ctogit/poncho-ciaa-rema/README.md

# poncho-ciaa-rema
Desarrollo de placa poncho para placa CIAA-NXP en el marco del proyecto de reacondicionamiento electrónico del telemanipulador cartesiano "REMA".
