ctogit/poncho-ciaa-rema/Fabricación_pcb_PonchoPicoCIAA.docx

PLACA PONCHO RPi-PICO/CIAA – PROYECTO REMA

Dimensiones: 138.6 mm x 86.19 mm

Capas: doble faz

1. Serigrafía capa superior
2. Máscara anti-soldante capa superior
3. Cobre capa superior
4. Cobre capa inferior
5. Máscara anti-soldante capa inferior
6. Serigrafía capa inferior

Agujeros metalizados: si

Material: FR4

Espesor: 1.6mm

Cantidad: 5

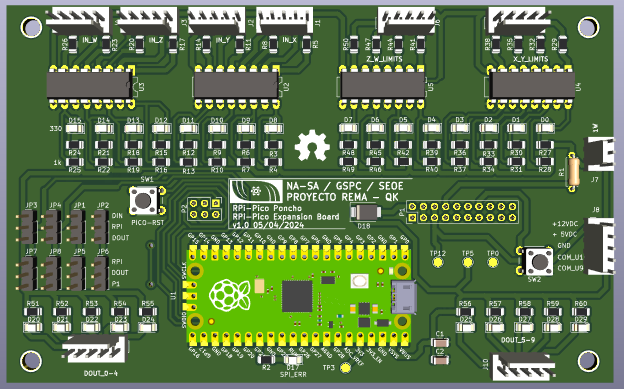
[picture p1: figure]
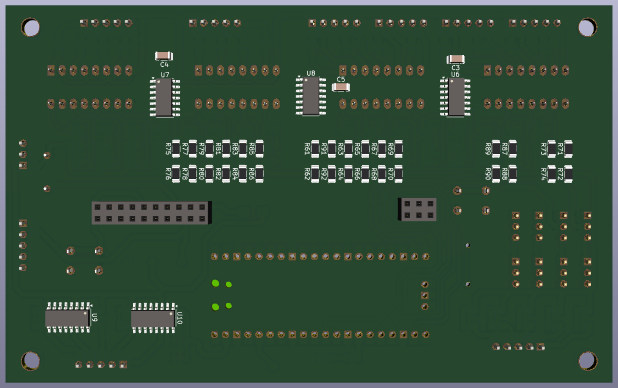
[picture p2: figure]
