ctogit/poncho-ciaa-rema/(list of files, drawings)

Other design files:
Simulaciones/PonchoTest.pdsprj
