ctogit/poncho-ciaa-rema/PonchoRema.kicad_pcb

## KiCad design PonchoRema.kicad_pcb (2024-04-05)

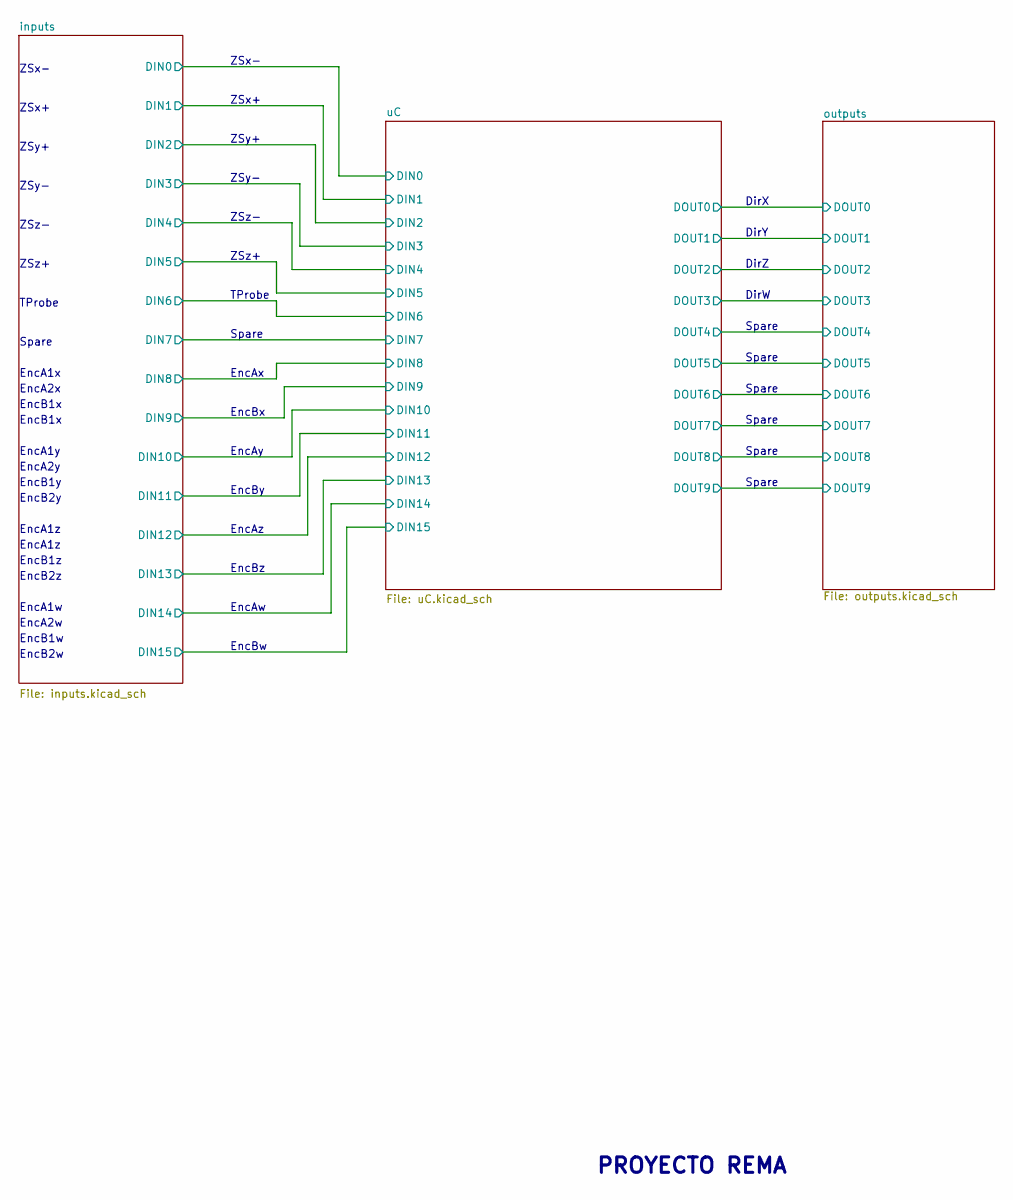
[picture p11: schematic PonchoRema.kicad_sch, Poncho-CIAA]

Notes on the sheet:
ZSx+
ZSz+
EncB1y
Spare
EncAy
EncAw
EncBz
ZSx-
EncB2y
EncA2y
TProbe
ZSy+
EncA1w
EncBx
EncB2z
ZSy-
EncB1x
EncB2w
EncB1z
EncA1z
EncBw
ZSz-
EncA2w
DirW
EncBy
EncAz
EncA1y
EncA2x
DirZ
DirY
EncAx
EncB1w
PROYECTO REMA
EncA1x
DirX

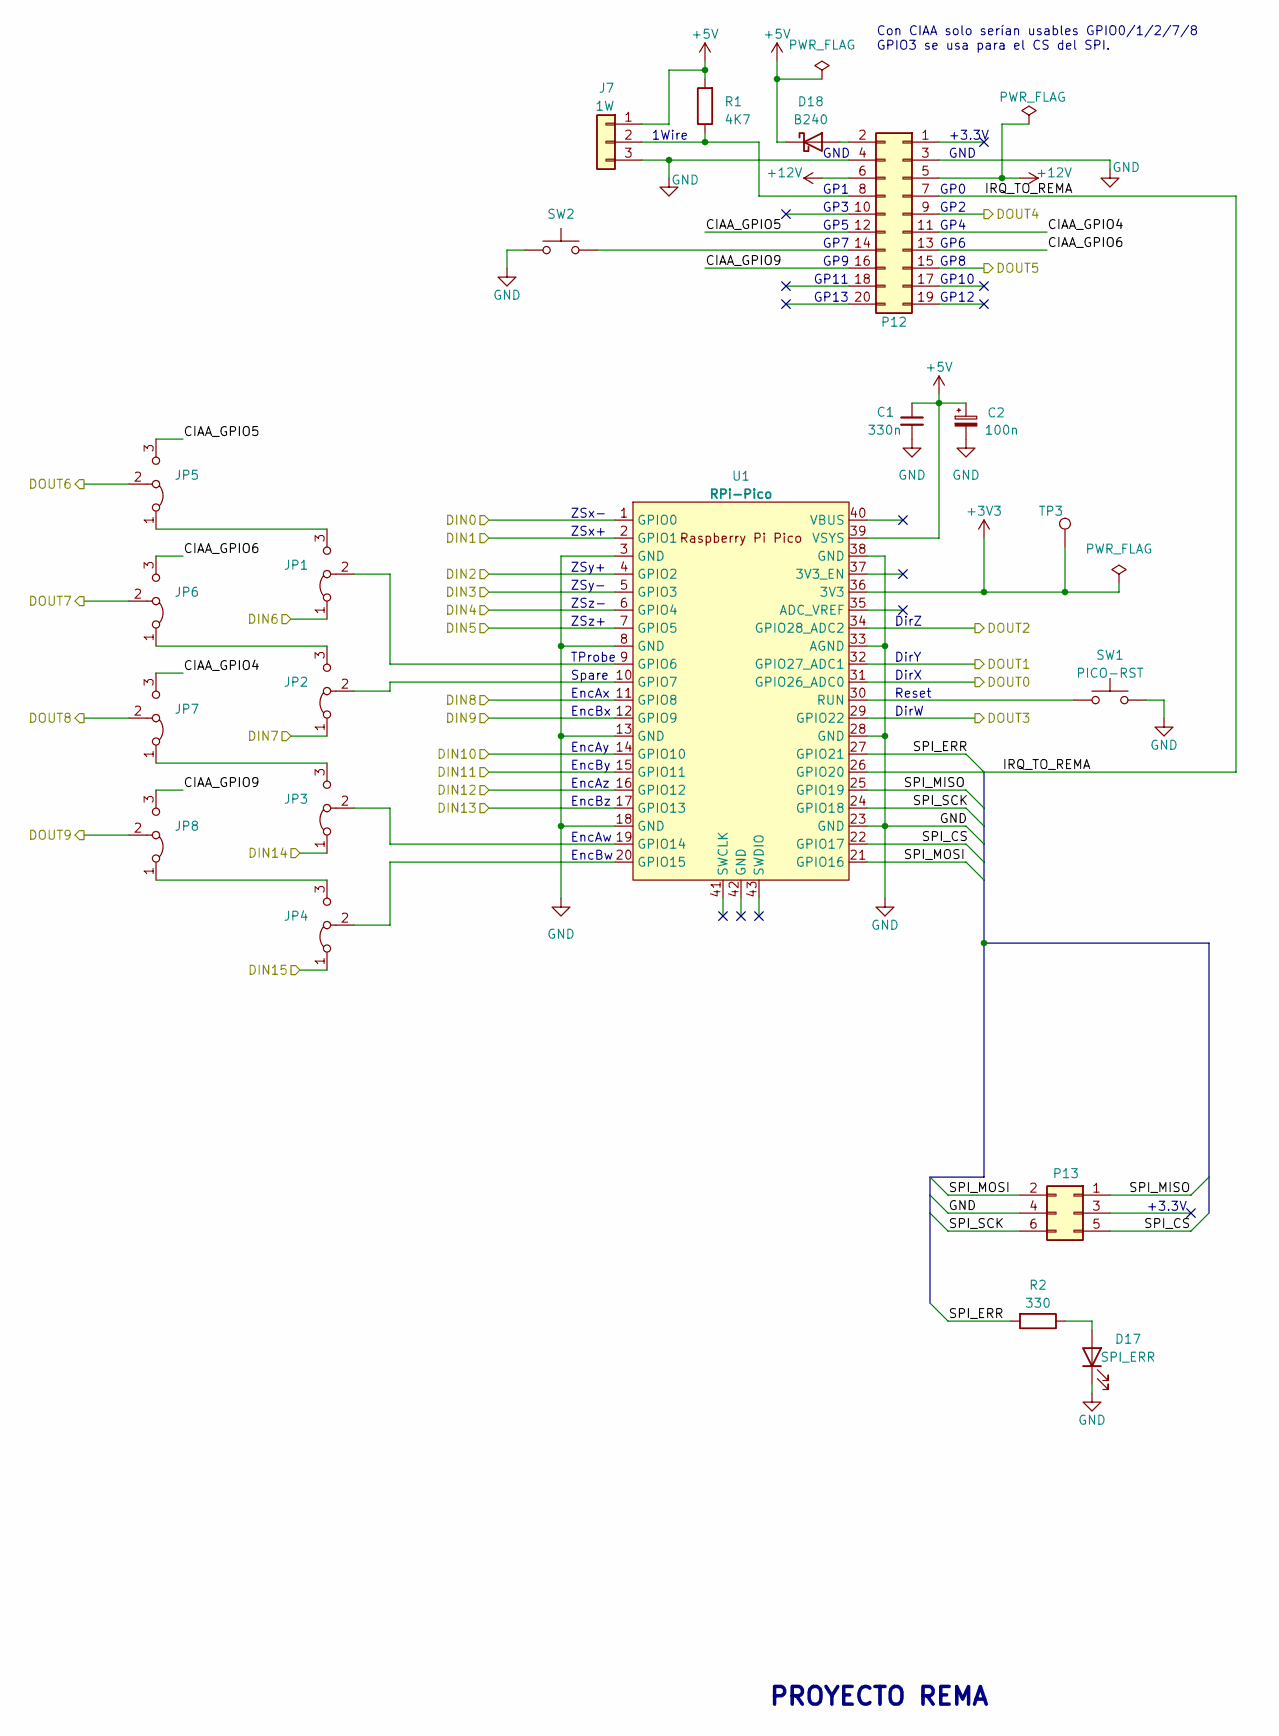
[picture p12: schematic uC.kicad_sch, Microcontrolador y fuentes]

Parts:
C1: 330n; C_1206_3216Metric
C2: 100n; C_1206_3216Metric
D17: SPI_ERR; LED_1206_3216Metric
D18: B240; D_SMB
J7: 1W; PinHeader_1x03_P2.54mm_Vertical
JP1, JP2, JP3, JP4, JP5, JP6, JP7, JP8: Jumper_3_Bridged12; PinHeader_1x03_P2.54mm_Vertical
P12: Conn_02x10_Odd_Even; PinHeader_2x10_P2.54mm_Vertical
P13: PinHeader_2x03_P2.54mm_Vertical
R1: 4K7; R_Axial_DIN0207_L6.3mm_D2.5mm_P7.62mm_Horizontal
R2: 330; R_1206_3216Metric
SW1: PICO-RST; SW_PUSH_6mm
SW2: SW_Push; SW_PUSH_6mm
TP3: TestPoint; TestPoint_Pad_D2.0mm
U1: RPi-Pico; RPi_Pico_SMD_TH

Connections:
+3V3: TP3.1, U1.36 (3V3)
+5V: C1.1, C2.1, D18.1 (K), J7.1, R1.2, U1.39 (VSYS); also elsewhere on the board
/inputs/DIN0: U1.1 (GPIO0); also elsewhere on the board
/inputs/DIN1: U1.2 (GPIO1); also elsewhere on the board
/inputs/DIN2: U1.4 (GPIO2); also elsewhere on the board
/inputs/DIN3: U1.5 (GPIO3); also elsewhere on the board
/inputs/DIN4: U1.6 (GPIO4); also elsewhere on the board
/inputs/DIN5: U1.7 (GPIO5); also elsewhere on the board
/inputs/DIN6: JP1.1 (A); also elsewhere on the board
/inputs/DIN7: JP2.1 (A); also elsewhere on the board
/inputs/DIN8: U1.11 (GPIO8); also elsewhere on the board
/inputs/DIN9: U1.12 (GPIO9); also elsewhere on the board
/inputs/DIN10: U1.14 (GPIO10); also elsewhere on the board
/inputs/DIN11: U1.15 (GPIO11); also elsewhere on the board
/inputs/DIN12: U1.16 (GPIO12); also elsewhere on the board
/inputs/DIN13: U1.17 (GPIO13); also elsewhere on the board
/inputs/DIN14: JP3.1 (A); also elsewhere on the board
/inputs/DIN15: JP4.1 (A); also elsewhere on the board
/outputs/DOUT0: U1.31 (GPIO26_ADC0); also elsewhere on the board
/outputs/DOUT1: U1.32 (GPIO27_ADC1); also elsewhere on the board
/outputs/DOUT2: U1.34 (GPIO28_ADC2); also elsewhere on the board
/outputs/DOUT3: U1.29 (GPIO22); also elsewhere on the board
/outputs/DOUT6: JP5.2 (C); also elsewhere on the board
/outputs/DOUT7: JP6.2 (C); also elsewhere on the board
/outputs/DOUT8: JP7.2 (C); also elsewhere on the board
/outputs/DOUT9: JP8.2 (C); also elsewhere on the board
/uC/CIAA_GPIO4: JP7.3 (B); also elsewhere on the board
/uC/CIAA_GPIO5: JP5.3 (B); also elsewhere on the board
/uC/CIAA_GPIO6: JP6.3 (B); also elsewhere on the board
/uC/CIAA_GPIO9: JP8.3 (B); also elsewhere on the board
/uC/IRQ_TO_REMA: U1.26 (GPIO20); also elsewhere on the board
/uC/SPI_CS: U1.22 (GPIO17); also elsewhere on the board
/uC/SPI_ERR: R2.2, U1.27 (GPIO21)
/uC/SPI_MISO: U1.25 (GPIO19); also elsewhere on the board
/uC/SPI_MOSI: U1.21 (GPIO16); also elsewhere on the board
/uC/SPI_SCK: U1.24 (GPIO18); also elsewhere on the board
GND: C1.2, C2.2, D17.1 (K), J7.3, SW1.2, SW2.1, U1.3 (GND), U1.8 (GND), U1.13 (GND), U1.18 (GND), U1.23 (GND), U1.28 (GND), U1.33 (AGND), U1.38 (GND); also elsewhere on the board
unnamed: D17.2 (A), R2.1
unnamed 84: D18.2 (A); also elsewhere on the board
unnamed 119: J7.2, R1.1; also elsewhere on the board
unnamed: JP1.3 (B), JP5.1 (A)
unnamed: JP1.2 (C), U1.9 (GPIO6)
unnamed: JP2.3 (B), JP6.1 (A)
unnamed: JP2.2 (C), U1.10 (GPIO7)
unnamed: JP3.3 (B), JP7.1 (A)
unnamed: JP3.2 (C), U1.19 (GPIO14)
unnamed: JP4.3 (B), JP8.1 (A)
unnamed: JP4.2 (C), U1.20 (GPIO15)
unnamed 130: SW2.2; also elsewhere on the board
unnamed: SW1.1, U1.30 (RUN)

Notes on the sheet:
GND
GP12
DirW
1Wire
ZSx-
GP1
ZSy-
ZSz-
GP6
EncAz
Con CIAA solo serían usables GPIO0/1/2/7/8 GPIO3 se usa para el CS del SPI.
Reset
GP13
GP8
EncBy
EncBz
ZSz+
DirX
GP2
EncBx
GP7
GP11
Spare
TProbe
GP9
EncAx
DirY
ZSx+
GP5
+3.3V
EncAy
GP3
ZSy+
GP10
EncAw
GP4
EncBw
GP0
PROYECTO REMA
DirZ

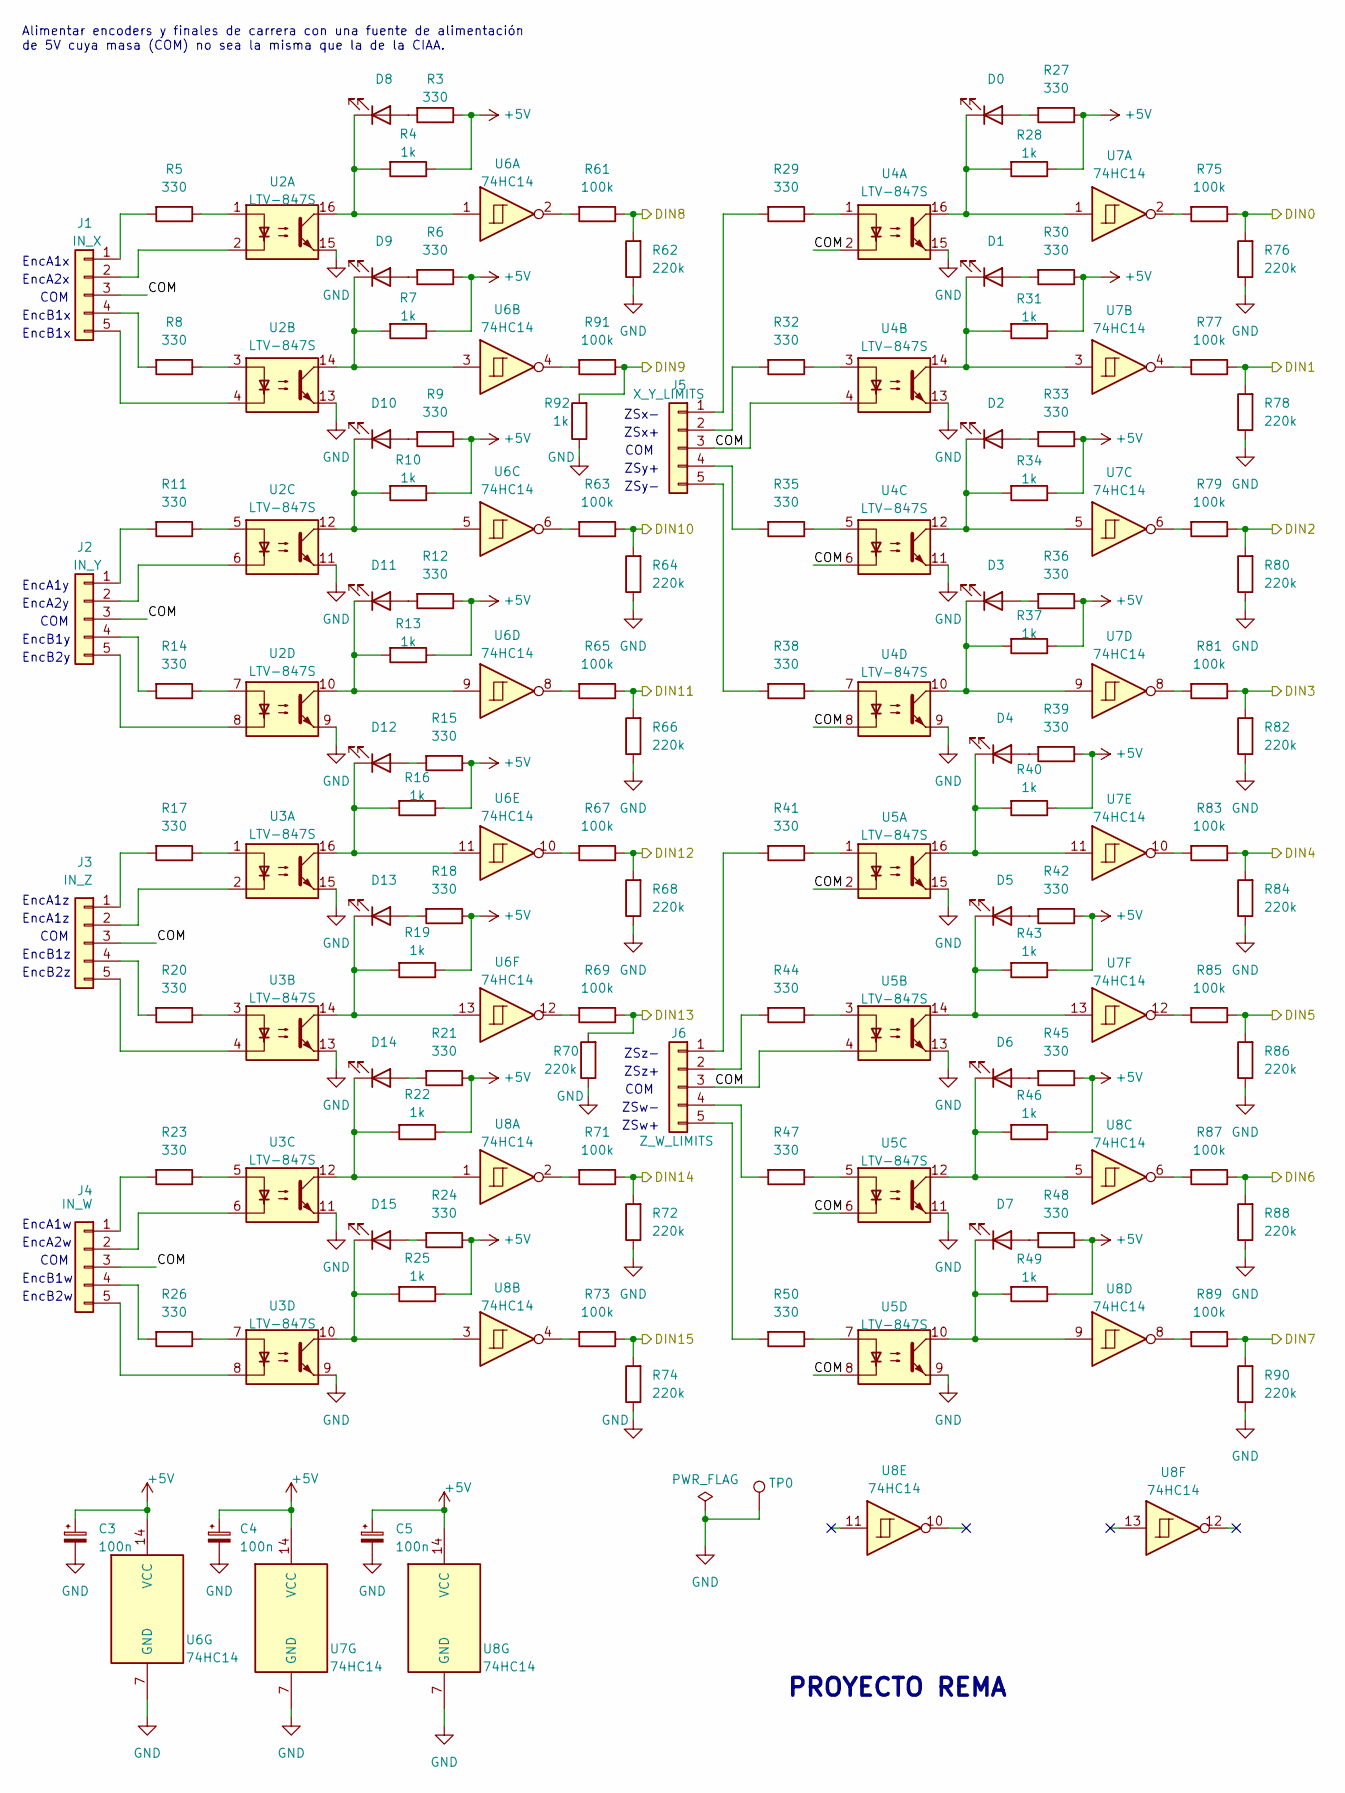
[picture p13: schematic inputs.kicad_sch, Entradas]

Parts:
C3, C4, C5: 100n; C_1206_3216Metric
D0, D1, D2, D3, D4, D5, D6, D7, D8, D9, D10, D11, D12, D13, D14, D15: LedGreen; LED_1206_3216Metric
J1: IN_X; PinHeader_1x05_P2.54mm_Vertical
J2: IN_Y; PinHeader_1x05_P2.54mm_Vertical
J3: IN_Z; PinHeader_1x05_P2.54mm_Vertical
J4: IN_W; PinHeader_1x05_P2.54mm_Vertical
J5: X_Y_LIMITS; PinHeader_1x05_P2.54mm_Vertical
J6: Z_W_LIMITS; PinHeader_1x05_P2.54mm_Vertical
R3, R5, R6, R8, R9, R11, R12, R14, R15, R17, R18, R20, R21, R23, R24, R26, R27, R29, R30, R32, R33, R35, R36, R38, R39, R41, R42, R44, R45, R47, R48, R50: 330; R_1206_3216Metric
R4, R7, R10, R13, R16, R19, R22, R25, R28, R31, R34, R37, R40, R43, R46, R49, R92: 1k; R_1206_3216Metric
R61, R63, R65, R67, R69, R71, R73, R75, R77, R79, R81, R83, R85, R87, R89, R91: 100k; R_1206_3216Metric
R62, R64, R66, R68, R70, R72, R74, R76, R78, R80, R82, R84, R86, R88, R90: 220k; R_1206_3216Metric
TP0: TestPoint; TestPoint_Pad_D2.0mm
U2, U3, U4, U5: LTV-847S; DIP-16_W7.62mm_LongPads
U6, U7, U8: 74HC14; SOIC-14_3.9x8.7mm_P1.27mm

Connections:
+5V: C3.1, C4.1, C5.1, R3.1, R4.1, R6.1, R7.1, R9.1, R10.1, R12.1, R13.1, R15.1, R16.1, R18.1, R19.1, R21.1, R22.1, R24.1, R25.1, R27.1, R28.1, R30.1, R31.1, R33.1, R34.1, R36.1, R37.1, R39.1, R40.1, R42.1, R43.1, R45.1, R46.1, R48.1, R49.1, U6.14 (VCC), U7.14 (VCC), U8.14 (VCC); also elsewhere on the board
/inputs/COM: J1.3, J2.3, J3.3, J4.3, J5.3, J6.3, U4.2, U4.4, U4.6, U4.8, U5.2, U5.4, U5.6, U5.8
/inputs/DIN0: R75.1, R76.2; also elsewhere on the board
/inputs/DIN1: R77.1, R78.2; also elsewhere on the board
/inputs/DIN2: R79.1, R80.2; also elsewhere on the board
/inputs/DIN3: R81.1, R82.2; also elsewhere on the board
/inputs/DIN4: R83.1, R84.2; also elsewhere on the board
/inputs/DIN5: R85.1, R86.2; also elsewhere on the board
/inputs/DIN6: R87.1, R88.2; also elsewhere on the board
/inputs/DIN7: R89.1, R90.2; also elsewhere on the board
/inputs/DIN8: R61.1, R62.2; also elsewhere on the board
/inputs/DIN9: R91.1, R92.2; also elsewhere on the board
/inputs/DIN10: R63.1, R64.2; also elsewhere on the board
/inputs/DIN11: R65.1, R66.2; also elsewhere on the board
/inputs/DIN12: R67.1, R68.2; also elsewhere on the board
/inputs/DIN13: R69.1, R70.2; also elsewhere on the board
/inputs/DIN14: R71.1, R72.2; also elsewhere on the board
/inputs/DIN15: R73.1, R74.2; also elsewhere on the board
GND: C3.2, C4.2, C5.2, R62.1, R64.1, R66.1, R68.1, R70.1, R72.1, R74.1, R76.1, R78.1, R80.1, R82.1, R84.1, R86.1, R88.1, R90.1, R92.1, TP0.1, U2.9, U2.11, U2.13, U2.15, U3.9, U3.11, U3.13, U3.15, U4.9, U4.11, U4.13, U4.15, U5.9, U5.11, U5.13, U5.15, U6.7 (GND), U7.7 (GND), U8.7 (GND); also elsewhere on the board
unnamed: D0.2 (A), R27.2
unnamed: D0.1 (K), R28.2, U4.16, U7.1
unnamed: D1.2 (A), R30.2
unnamed: D1.1 (K), R31.2, U4.14, U7.3
unnamed: D2.2 (A), R33.2
unnamed: D2.1 (K), R34.2, U4.12, U7.5
unnamed: D3.2 (A), R36.2
unnamed: D3.1 (K), R37.2, U4.10, U7.9
unnamed: D4.2 (A), R39.2
unnamed: D4.1 (K), R40.2, U5.16, U7.11
unnamed: D5.2 (A), R42.2
unnamed: D5.1 (K), R43.2, U5.14, U7.13
unnamed: D6.2 (A), R45.2
unnamed: D6.1 (K), R46.2, U5.12, U8.5
unnamed: D7.2 (A), R48.2
unnamed: D7.1 (K), R49.2, U5.10, U8.9
unnamed: D8.2 (A), R3.2
unnamed: D8.1 (K), R4.2, U2.16, U6.1
unnamed: D9.2 (A), R6.2
unnamed: D9.1 (K), R7.2, U2.14, U6.3
unnamed: D10.2 (A), R9.2
unnamed: D10.1 (K), R10.2, U2.12, U6.5
unnamed: D11.2 (A), R12.2
unnamed: D11.1 (K), R13.2, U2.10, U6.9
unnamed: D12.2 (A), R15.2
unnamed: D12.1 (K), R16.2, U3.16, U6.11
unnamed: D13.2 (A), R18.2
unnamed: D13.1 (K), R19.2, U3.14, U6.13
unnamed: D14.2 (A), R21.2
unnamed: D14.1 (K), R22.2, U3.12, U8.1
unnamed: D15.2 (A), R24.2
unnamed: D15.1 (K), R25.2, U3.10, U8.3
unnamed: J1.1, R5.2
unnamed: J1.2, U2.2
unnamed: J1.4, R8.2
unnamed: J1.5, U2.4
unnamed: J2.1, R11.2
unnamed: J2.2, U2.6
unnamed: J2.4, R14.2
unnamed: J2.5, U2.8
unnamed: J3.1, R17.2
unnamed: J3.2, U3.2
unnamed: J3.4, R20.2
unnamed: J3.5, U3.4
unnamed: J4.1, R23.2
unnamed: J4.2, U3.6
unnamed: J4.4, R26.2
unnamed: J4.5, U3.8
unnamed: J5.1, R29.2
unnamed: J5.2, R32.2
unnamed: J5.4, R35.2
unnamed: J5.5, R38.2
unnamed: J6.1, R41.2
unnamed: J6.2, R44.2
unnamed: J6.4, R47.2
unnamed: J6.5, R50.2
unnamed: R5.1, U2.1
unnamed: R8.1, U2.3
unnamed: R11.1, U2.5
unnamed: R14.1, U2.7
unnamed: R17.1, U3.1
unnamed: R20.1, U3.3
unnamed: R23.1, U3.5
unnamed: R26.1, U3.7
unnamed: R29.1, U4.1
unnamed: R32.1, U4.3
unnamed: R35.1, U4.5
unnamed: R38.1, U4.7
unnamed: R41.1, U5.1
unnamed: R44.1, U5.3
unnamed: R47.1, U5.5
unnamed: R50.1, U5.7
unnamed: R61.2, U6.2
unnamed: R63.2, U6.6
unnamed: R65.2, U6.8
unnamed: R67.2, U6.10
unnamed: R69.2, U6.12
unnamed: R71.2, U8.2
unnamed: R73.2, U8.4
unnamed: R75.2, U7.2
unnamed: R77.2, U7.4
unnamed: R79.2, U7.6
unnamed: R81.2, U7.8
unnamed: R83.2, U7.10
unnamed: R85.2, U7.12
unnamed: R87.2, U8.6
unnamed: R89.2, U8.8
unnamed: R91.2, U6.4

Notes on the sheet:
ZSy+
EncA2w
ZSz-
EncA1z
ZSx+
COM
EncB1w
EncA1w
EncB1y
EncA1x
EncB2y
EncA2y
PROYECTO REMA
EncB1z
ZSw-
Alimentar encoders y finales de carrera con una fuente de alimentación de 5V cuya masa (COM) no sea la misma que la de la CIAA.
EncB1x
EncA1y
EncB2z
ZSx-
ZSz+
ZSw+
ZSy-
EncA2x
EncB2w

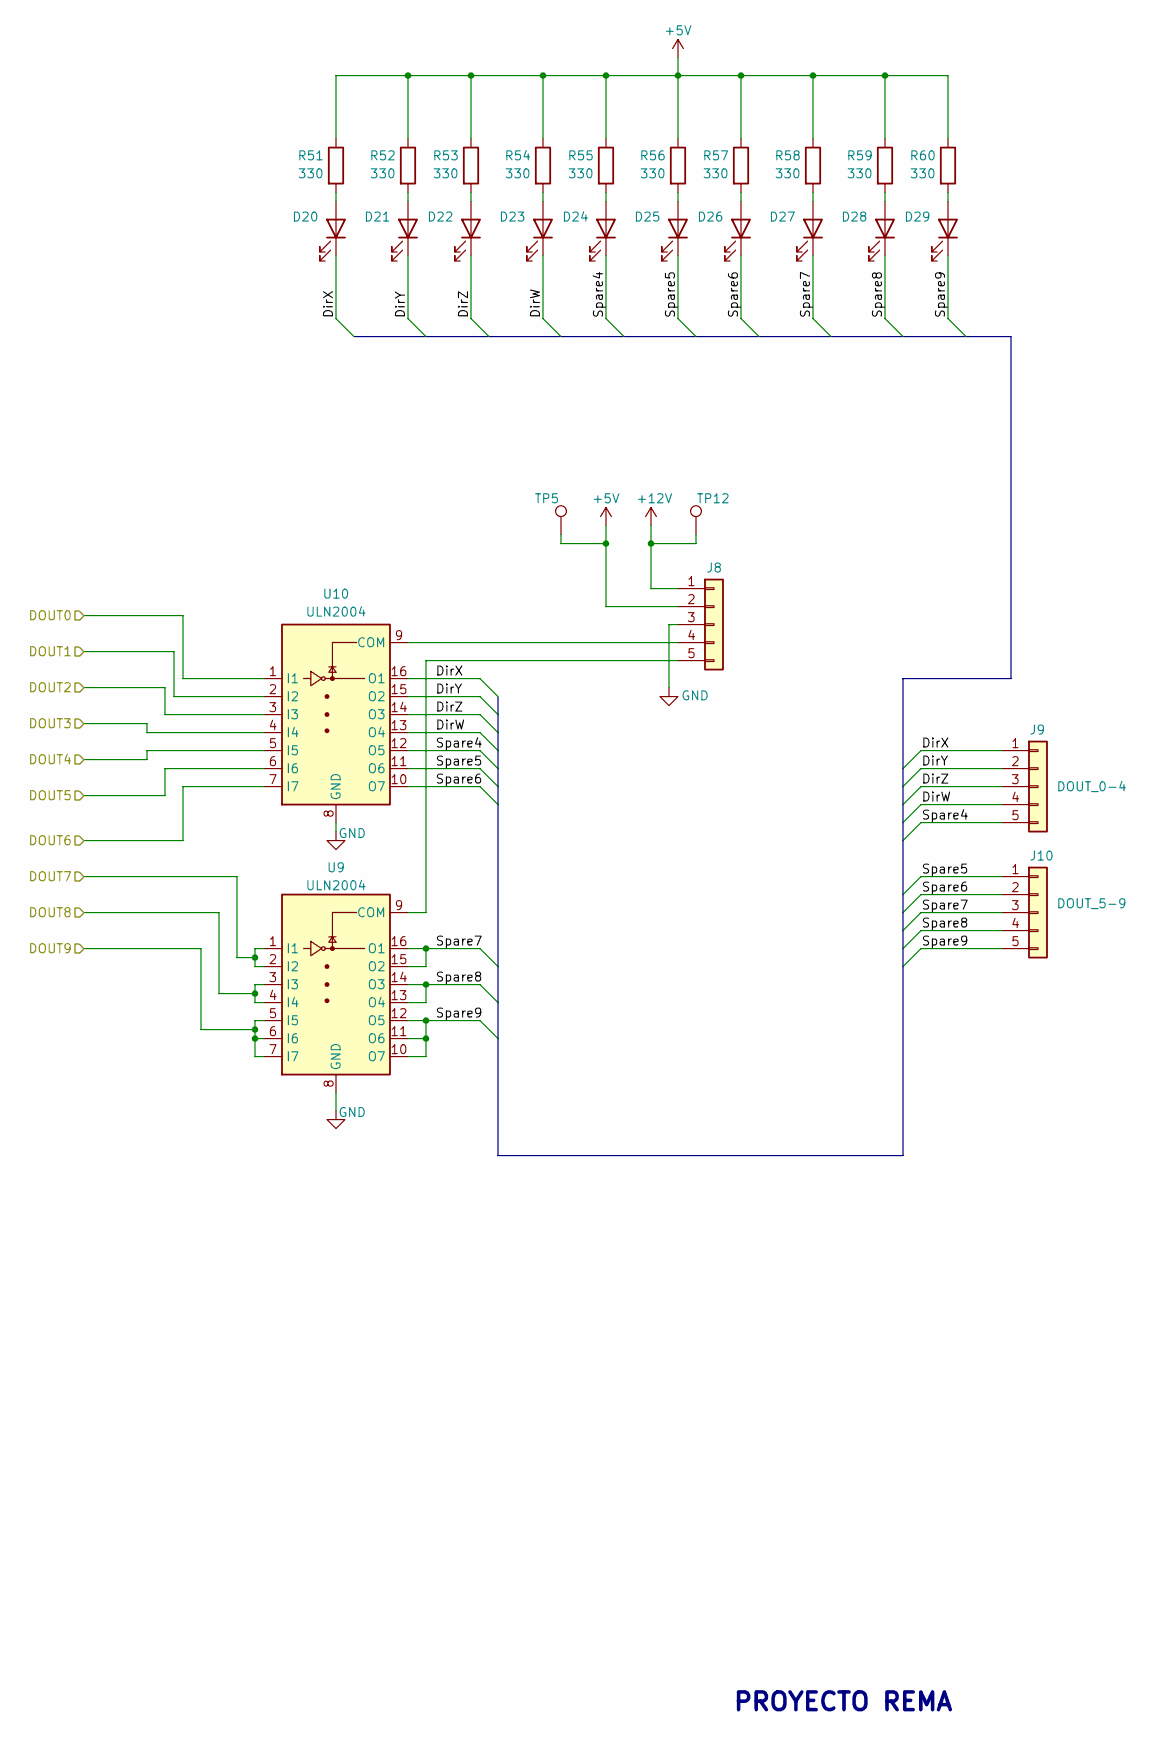
[picture p14: schematic outputs.kicad_sch, Salidas]

Parts:
D20, D21, D22, D23, D24, D25, D26, D27, D28, D29: LedRed; LED_1206_3216Metric
J8: Conn_01x05; PinHeader_1x05_P2.54mm_Vertical
J9: DOUT_0-4; PinHeader_1x05_P2.54mm_Vertical
J10: DOUT_5-9; PinHeader_1x05_P2.54mm_Vertical
R51, R52, R53, R54, R55, R56, R57, R58, R59, R60: 330; R_1206_3216Metric
TP5, TP12: TestPoint; TestPoint_Pad_D2.0mm
U9, U10: ULN2004; SO-16_3.9x9.9mm_P1.27mm

Connections:
+5V: J8.2, R51.1, R52.1, R53.1, R54.1, R55.1, R56.1, R57.1, R58.1, R59.1, R60.1, TP5.1; also elsewhere on the board
+12V: J8.1, TP12.1; also elsewhere on the board
/outputs/DOUT0: U10.1 (I1); also elsewhere on the board
/outputs/DOUT1: U10.2 (I2); also elsewhere on the board
/outputs/DOUT2: U10.3 (I3); also elsewhere on the board
/outputs/DOUT3: U10.4 (I4); also elsewhere on the board
/outputs/DOUT4: U10.5 (I5); also elsewhere on the board
/outputs/DOUT5: U10.6 (I6); also elsewhere on the board
/outputs/DOUT6: U10.7 (I7); also elsewhere on the board
/outputs/DOUT7: U9.1 (I1), U9.2 (I2); also elsewhere on the board
/outputs/DOUT8: U9.3 (I3), U9.4 (I4); also elsewhere on the board
/outputs/DOUT9: U9.5 (I5), U9.6 (I6), U9.7 (I7); also elsewhere on the board
/outputs/DirW: D23.1 (K), J9.4, U10.13 (O4)
/outputs/DirX: D20.1 (K), J9.1, U10.16 (O1)
/outputs/DirY: D21.1 (K), J9.2, U10.15 (O2)
/outputs/DirZ: D22.1 (K), J9.3, U10.14 (O3)
/outputs/Spare4: D24.1 (K), J9.5, U10.12 (O5)
/outputs/Spare5: D25.1 (K), J10.1, U10.11 (O6)
/outputs/Spare6: D26.1 (K), J10.2, U10.10 (O7)
/outputs/Spare7: D27.1 (K), J10.3, U9.15 (O2), U9.16 (O1)
/outputs/Spare8: D28.1 (K), J10.4, U9.13 (O4), U9.14 (O3)
/outputs/Spare9: D29.1 (K), J10.5, U9.10 (O7), U9.11 (O6), U9.12 (O5)
GND: J8.3, U9.8 (GND), U10.8 (GND); also elsewhere on the board
unnamed: D20.2 (A), R51.2
unnamed: D21.2 (A), R52.2
unnamed: D22.2 (A), R53.2
unnamed: D23.2 (A), R54.2
unnamed: D24.2 (A), R55.2
unnamed: D25.2 (A), R56.2
unnamed: D26.2 (A), R57.2
unnamed: D27.2 (A), R58.2
unnamed: D28.2 (A), R59.2
unnamed: D29.2 (A), R60.2
unnamed: J8.4, U10.9 (COM)
unnamed: J8.5, U9.9 (COM)

Notes on the sheet:
PROYECTO REMA

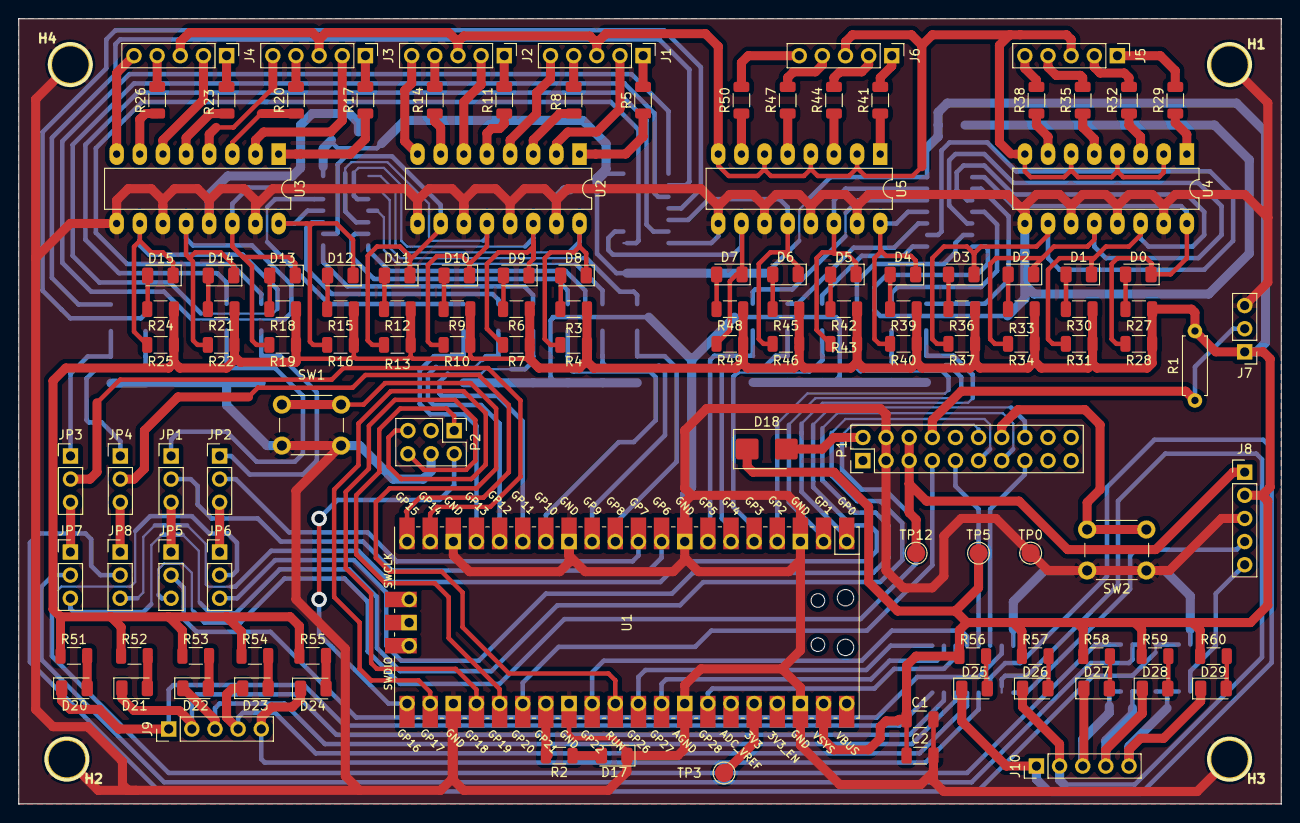
[picture p15: board PonchoRema.kicad_pcb from above]

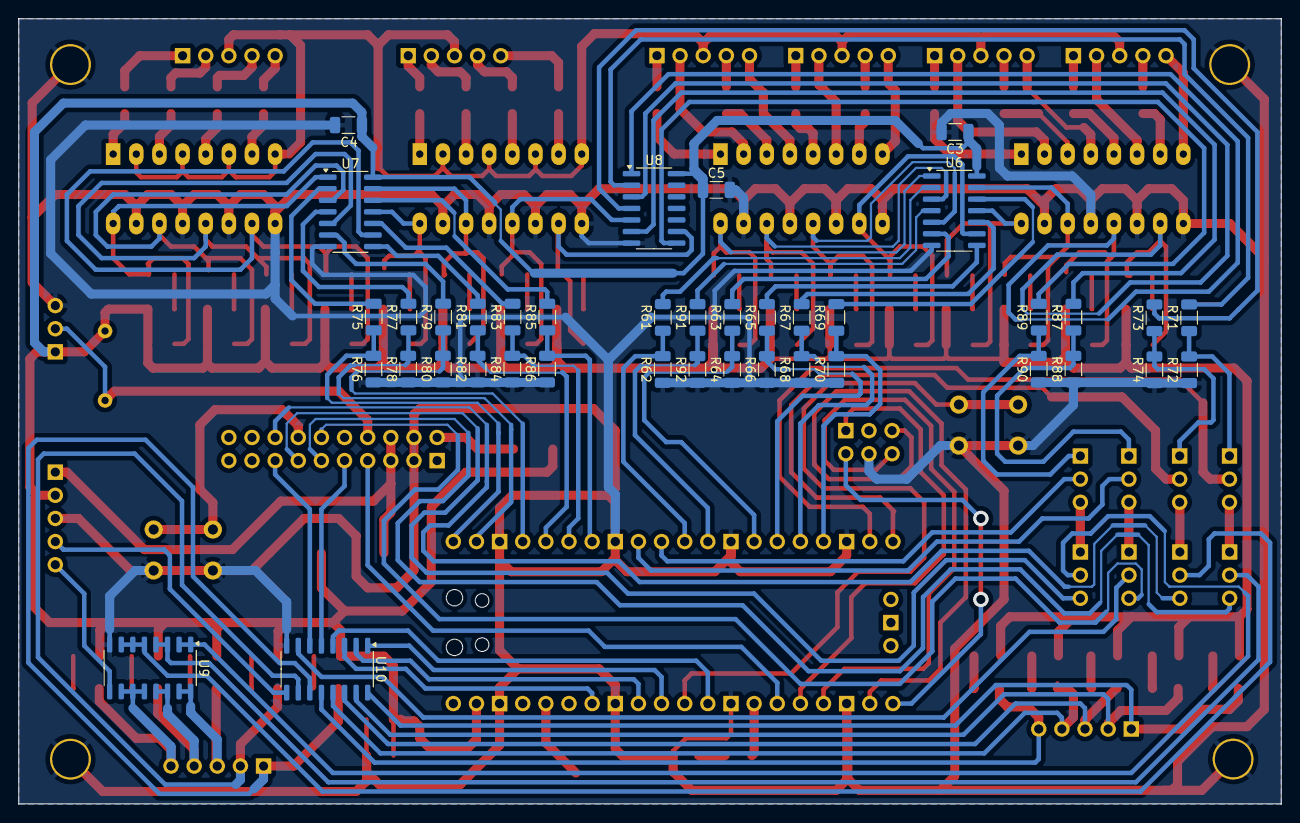
[picture p16: board PonchoRema.kicad_pcb from below]

Board: 2 copper layers, 138.6 x 86.2 mm, 165 parts (40 on the bottom side), 164 nets.

Other parts of the board:
H1, H2, H3, H4: 4mm; 1pin
P1: Conn_02x10_Odd_Even; PinHeader_2x10_P2.54mm_Vertical
P2: PinHeader_2x03_P2.54mm_Vertical

Their connections:
+12V: P1.5, P1.6; also elsewhere on the board
/outputs/DOUT4: P1.9; also elsewhere on the board
/outputs/DOUT5: P1.15; also elsewhere on the board
/uC/CIAA_GPIO4: P1.11; also elsewhere on the board
/uC/CIAA_GPIO5: P1.12; also elsewhere on the board
/uC/CIAA_GPIO6: P1.13; also elsewhere on the board
/uC/CIAA_GPIO9: P1.16; also elsewhere on the board
/uC/IRQ_TO_REMA: P1.7; also elsewhere on the board
/uC/SPI_CS: P2.5; also elsewhere on the board
/uC/SPI_MISO: P2.1; also elsewhere on the board
/uC/SPI_MOSI: P2.2; also elsewhere on the board
/uC/SPI_SCK: P2.6; also elsewhere on the board
GND: H1.1, H2.1, H3.1, H4.1, P1.3, P1.4, P2.4; also elsewhere on the board
unnamed 84: P1.2; also elsewhere on the board
unnamed 119: P1.8; also elsewhere on the board
unnamed 130: P1.14; also elsewhere on the board
