ctogit/poncho-ciaa-rema/(commit log)

2024-03-25 Circuito esqumático listo, falta ver los footprints de cada componente e iniciar el diseño del pcb
    [PonchoRema.kicad_pcb, PonchoRema.kicad_sch, inputs.kicad_sch, outputs.kicad_sch, uC.kicad_sch]
2024-03-26 Avances en corrección de errores en conexiones eléctricas (ERC).
    [PonchoRema.kicad_sch, inputs.kicad_sch, outputs.kicad_sch, uC.kicad_sch]
2024-03-26 Se corrigieron errores de conexión. Falta asignar footprints aún
    [PonchoRema.kicad_sch, inputs.kicad_sch, outputs.kicad_sch, uC.kicad_sch]
2024-03-27 se agregan jumpers para elegir entre entradas/salidas
    [uC.kicad_sch]
2024-03-27 Esquemático listo, sin errores de conexión y con todos los footprints especificados
    [inputs.kicad_sch, outputs.kicad_sch, uC.kicad_sch]
2024-03-27 Se agrega carpeta que contiene los simbolos, footprints y modelo 3D de la RPi-pico
2024-03-27 Comienza el diseño del pcb
    [PonchoRema.kicad_pcb, inputs.kicad_sch, outputs.kicad_sch, uC.kicad_sch]
2024-03-28 Avances con el pcb antes de un laaargo finde
    [PonchoRema.kicad_pcb]
2024-04-03 Se agregan divisores resisitivos a la salida de los schmitt triggers para asegurar que no le lleguen 5V a las entradas de la pico. Se acutaliza el pcb y se acomodan los componentes en dos capas
    [PonchoRema.kicad_pcb, inputs.kicad_sch, uC.kicad_sch]
2024-04-03 Comienza ruteo en pcb
    [PonchoRema.kicad_pcb, inputs.kicad_sch, outputs.kicad_sch, uC.kicad_sch]
2024-04-04 capa top lista, falta capa bottom del pcb
    [PonchoRema.kicad_pcb, PonchoTest.pdsprj]
2024-04-05 PCB: Faltan rutear 4 líneas de la capa bottom
    [PonchoRema.kicad_pcb, uC.kicad_sch]
2024-04-05 pcb listo, ver detalles
    [PonchoRema.kicad_pcb, inputs.kicad_sch, uC.kicad_sch]
2024-04-06 Placa poncho v1.0 lista para fabricar
2024-04-08 Terminaciones menores y generación de pdf para cotización
2024-04-10 Se reemplaza ULN2004 por ULN2003 ya que este último es compatible con entradas 3V3. Se optimiza el pcb en cuanto a pistas y planos de masa debajo de los ULN.
    [outputs.kicad_sch]
2024-04-12 Se generan archivos gerber y se procede a fabricar.
    [PonchoRema-B_Cu.gbr, PonchoRema-B_Mask.gbr, PonchoRema-B_Paste.gbr, PonchoRema-B_Silkscreen.gbr, PonchoRema-Edge_Cuts.gbr, PonchoRema-F_Cu.gbr, PonchoRema-F_Mask.gbr, PonchoRema-F_Paste.gbr]
